RotcivSnitram/Medidor-de-fluxo-de-ar/README.md

# Medidor-de-fluxo-de-ar
O objetivo final do projeto consiste na montagem de um medidor de vácuo. Como base estabelecida nesse projeto atual, foi realizada a construção de um medidor de fluxo de ar como primeiro passo para a criação de um medidor de vácuo do tipo Pirani. O experimento consiste numa ponte de Wheatstone com resistores de valores próximos à resistência do filamento utilizado. A resistência do filamento varia com sua temperatura, que por sua vez será reduzida pelo fluxo de ar. Utilizamos um circuito de amplificação para conexão com o Arduino Uno que faria a aquisição visual dos dados.
