RotcivSnitram/Medidor-de-fluxo-de-ar/MEDIDOR DE FLUXO DE AR.pptx

## MEDIDOR DE FLUXO DE AR

Daniel Giardini Lorang E victor hugo martins de souza

## Medidor de vácuo do tipo pirani

- Ponte de Wheatstone;
- Depende do tipo de gás;
- Existem três tipos desse medidor tipo Pirani (tensão constante, corrente constante e resistência constante).

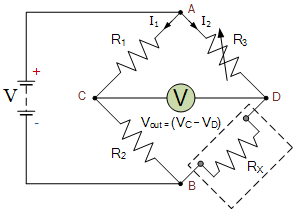
[picture p1: figure]

## Dificuldades encontradas

- Falta de material detalhado sobre a construção e os circuitos para o medidor de vácuo tipo Pirani;
- Circuitos amplificadores da ponte de Wheatstone;
- Incompatibilidade de diversas componentes com os circuitos testados;
- Adaptação do módulo conversor e amplificador HX711.

## Medidor de fluxo de ar

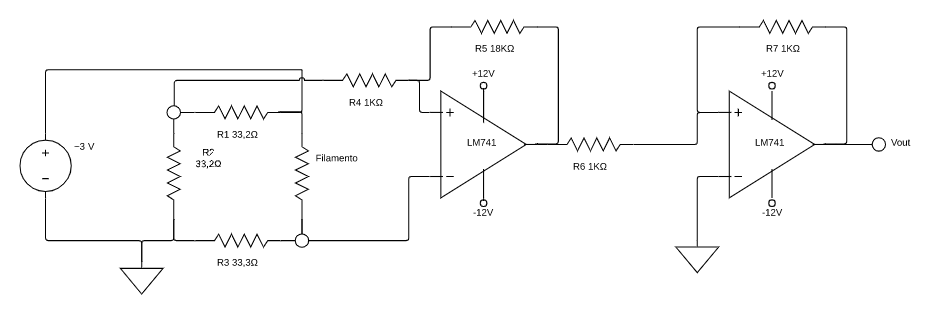
[picture p2: figure]

- Princípio de funcionamento do circuito;
- Analogia com o medidor de vácuo.

## Equipamentos utilizados

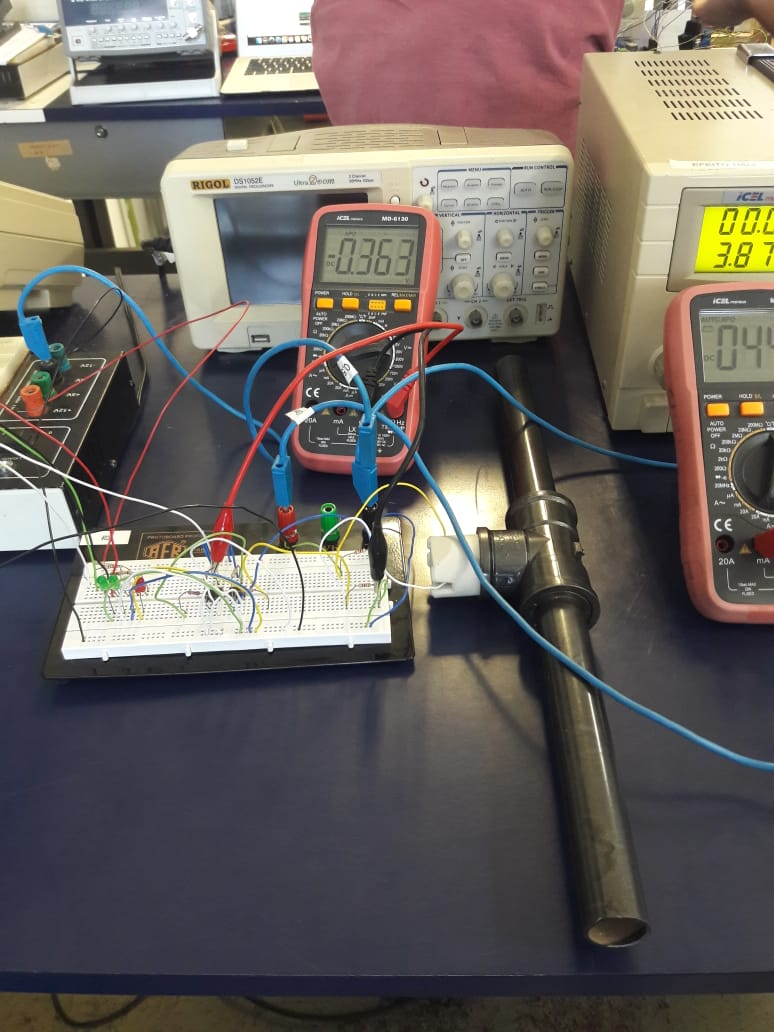
[picture p3: figure]

- Amplificadores operacionais LM741;
- Lâmpada incandescente tipo vela;
- Arduino Uno R3;
- LED’s;
- Tubo e conexão T de PVC;

## Filamento de lâmpada como sensor

- Variação da resistência;
- Calibração da resistência do filamento;
- Calibração do programa do Arduino;
- Cuidados.

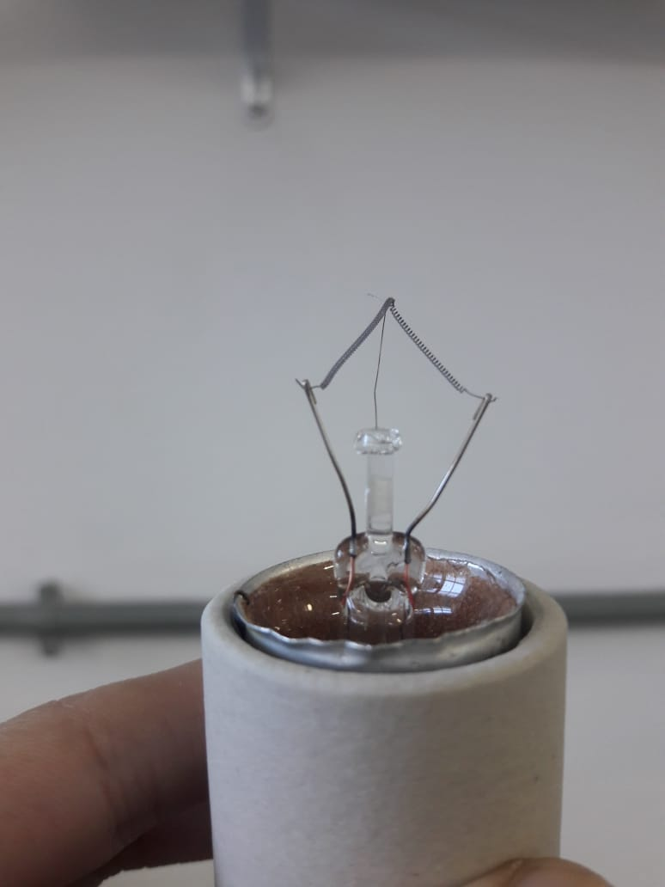
[picture p4: figure]

## Circuito do Medidor do fluxo de ar

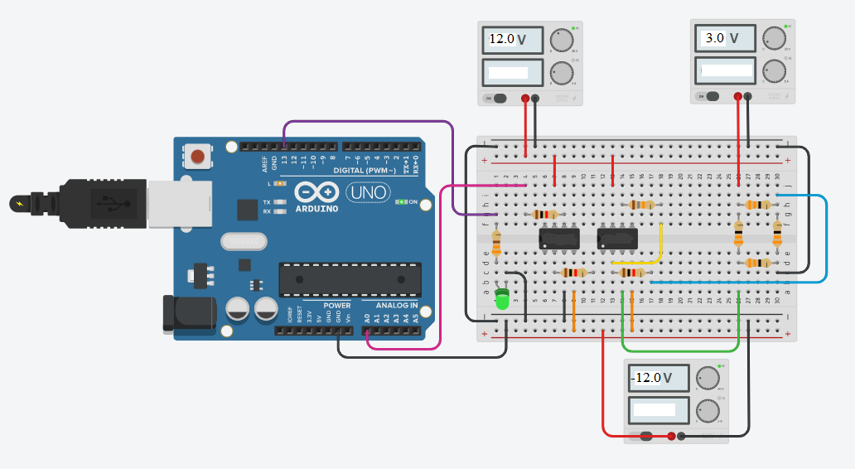
[picture p5: figure]

## Propostas de aprimoramento

- Introdução ao código do Arduino a tomada de medidas de referência para fazer a calibração automática;
- Construção do sistema de vácuo;
- Testar o funcionamento do medidor em um ambiente controlado utilizando diferentes tipos de gases para comparação do comportamento;
- Adaptação do circuito para o medidor de vácuo.

## obrigado
